TataThanapat/IREC2025_FlightCom/IREC2025_FlightComputer.kicad_pcb

## KiCad design IREC2025_FlightComputer.kicad_pcb (2025-05-31)

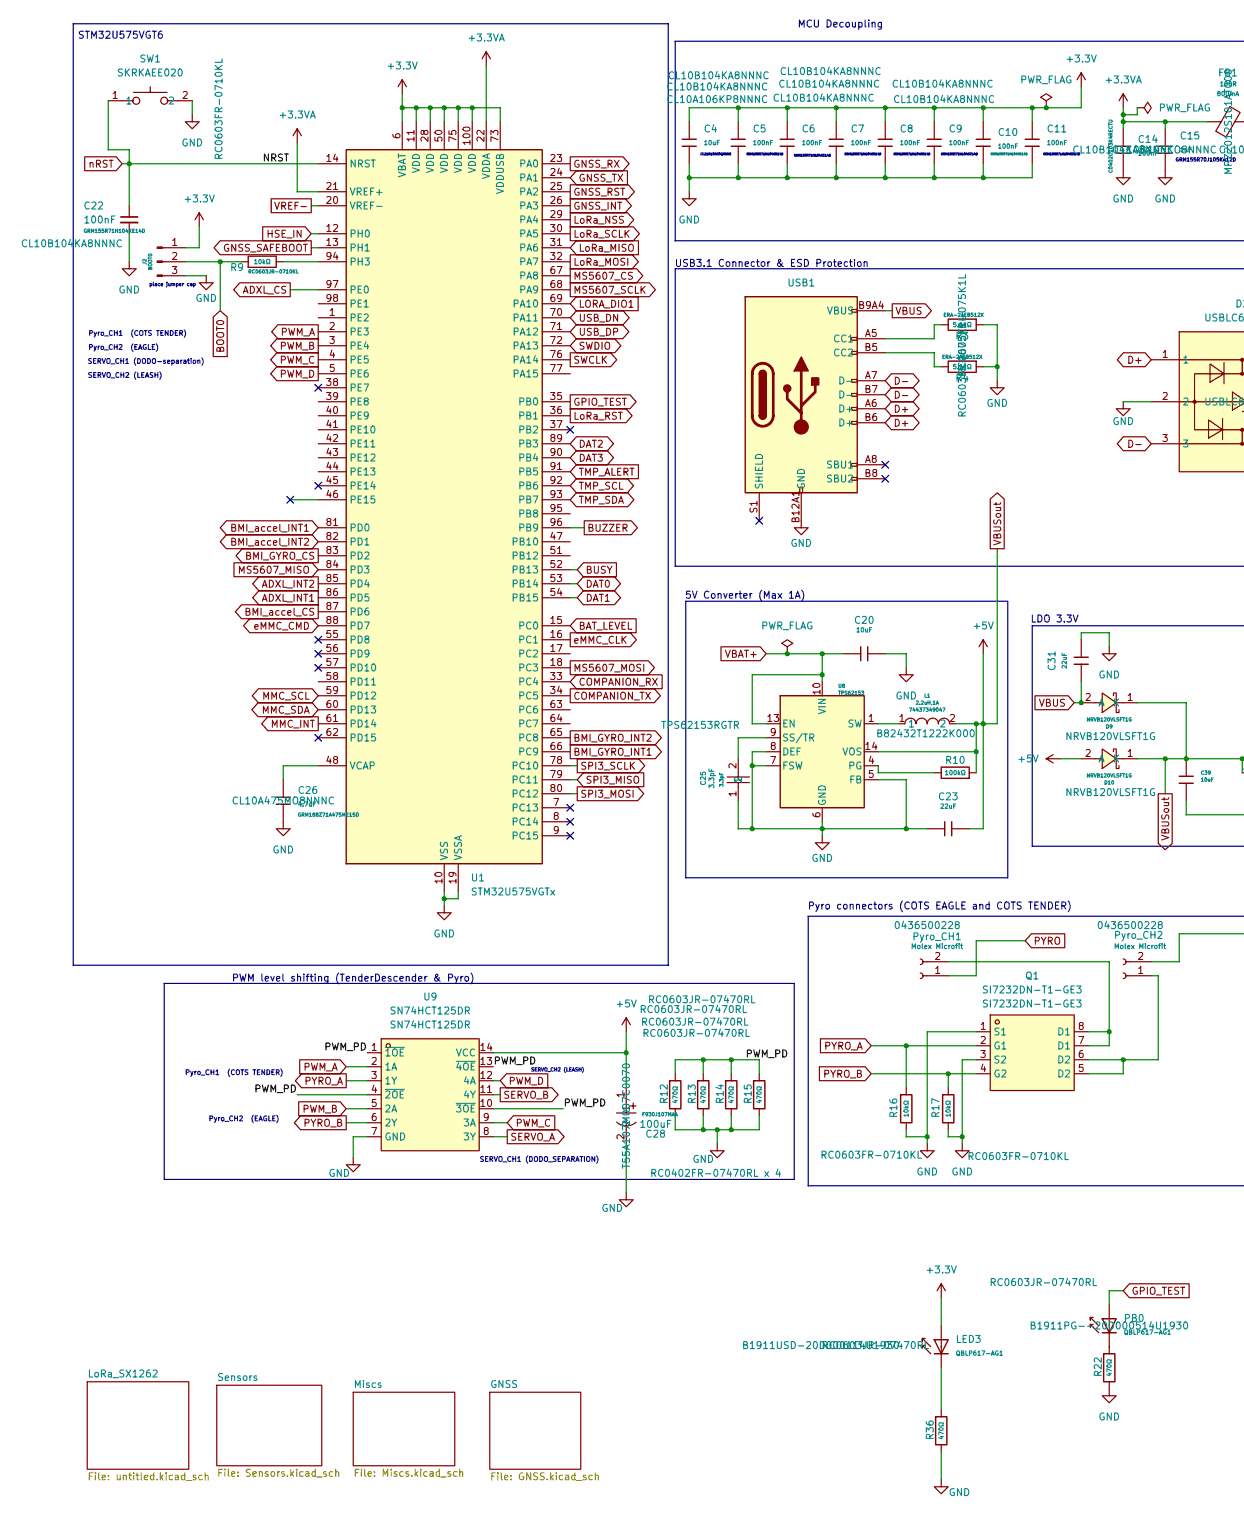
[picture p1: schematic IREC2025_FlightComputer.kicad_sch, part in row 1, column 1]

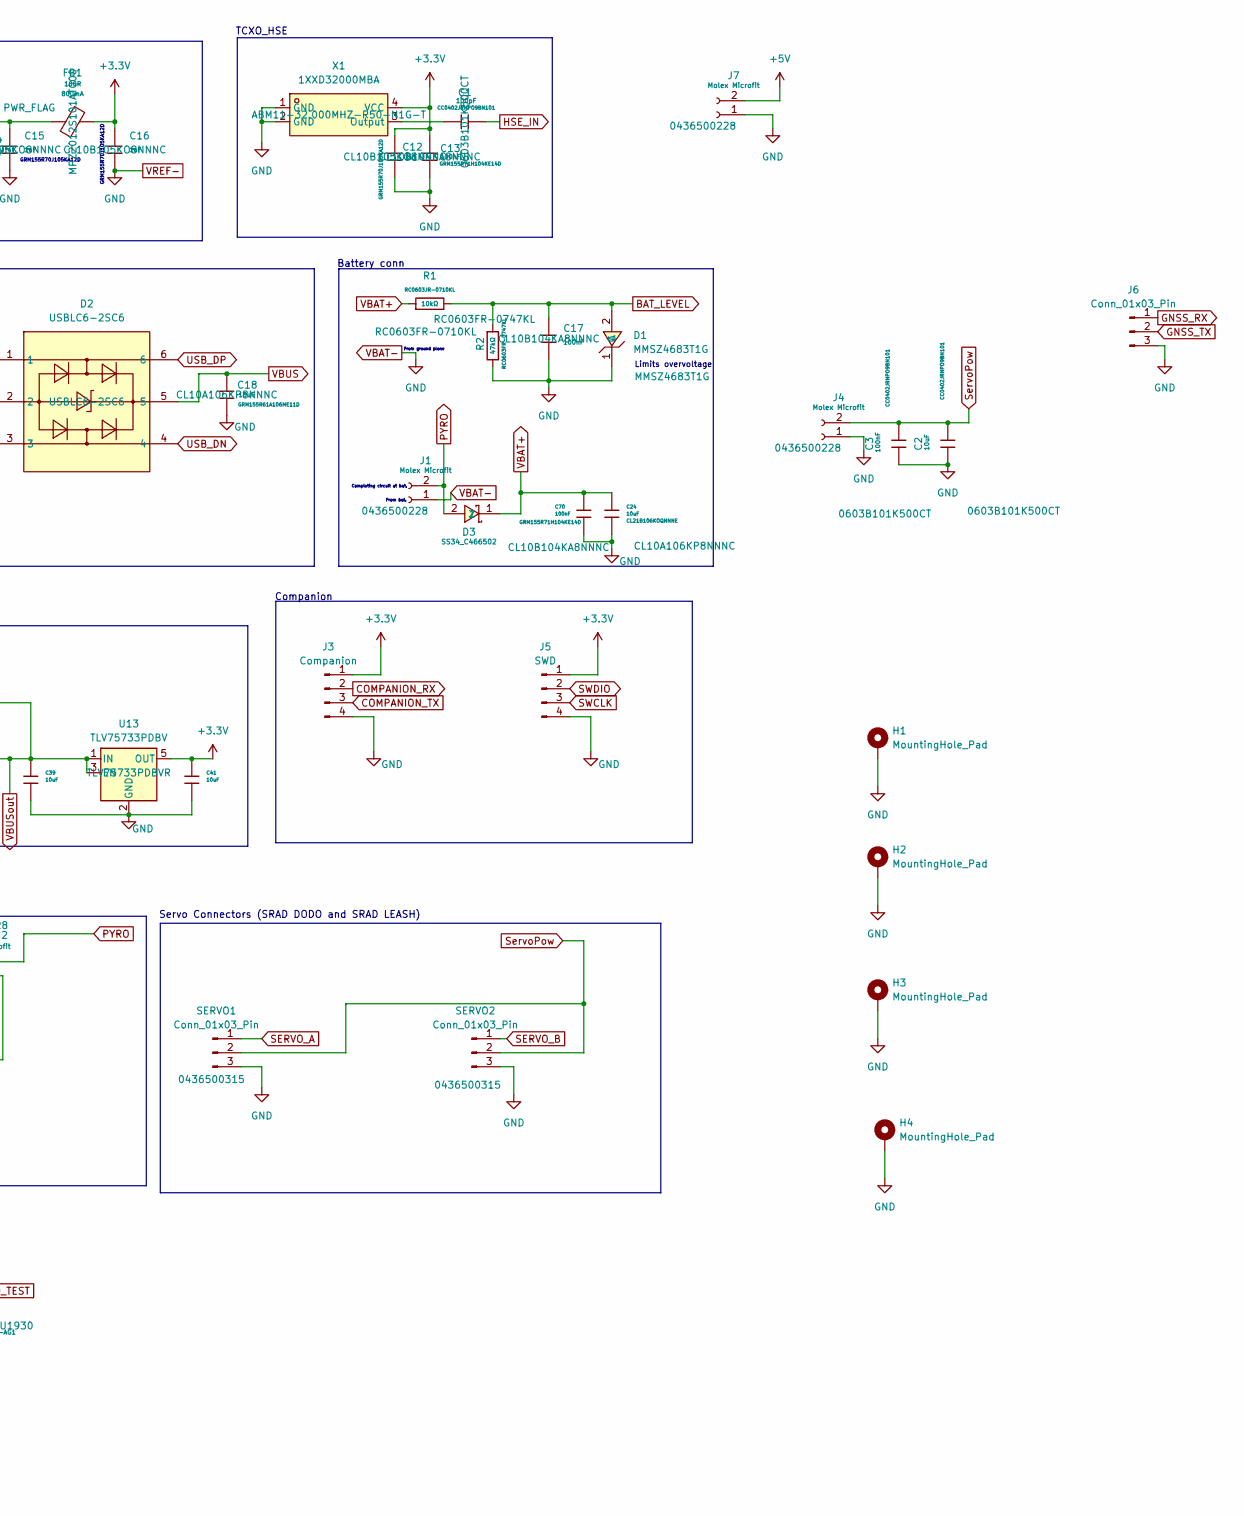
[picture p2: schematic IREC2025_FlightComputer.kicad_sch, part in row 1, column 2]

Parts:
C1: 100pF; C_0603; Voltage Rated 50V; Tolerance ±5%; Part 0402CG101J500NT; LCSC C1546
C2: 10uF; C_0603; Voltage Rated 50V; Tolerance ±5%; Part 0402CG101J500NT; LCSC C1546
C3: 100nF; C_0603; Voltage Rated 50V; Tolerance ±5%; Part 0402CG101J500NT; LCSC C1546
C4, C18: 10uF; C_0603; Voltage Rated 6.3V; Tolerance ±20%; Part CL05A106MQ5NUNC; LCSC C15525
C5, C6, C7, C8, C9, C10, C11, C13, C17: 100nF; C_0603; Voltage Rated 16V; Tolerance ±10%; Part CL05B104KO5NNNC; LCSC C1525
C12, C15, C16: 1uF; C_0603; Voltage Rated 25V; Tolerance ±10%; Part CL05A105KA5NQNC; LCSC C52923
C14: 100nF; C_0603; Voltage Rated 50V; Tolerance ±10%; Part CL05B103KB5NNNC; LCSC C15195
C20: 10uF; C_0603; Voltage Rated 25V; Tolerance ±20%; Part CL10A106MA8NRNC; LCSC C96446
C22: 100nF; C_0603; Digikey Parts CL10B104KA8NNNC
C23, C31: 22uF; C_0603; Voltage Rated 6.3V; Tolerance ±20%; Part CL10A226MQ8NRNC; LCSC C59461
C24, C39, C41: 10uF; C_0603; Voltage Rated 50V; Tolerance ±10%; Part CL31A106KBHNNNE; LCSC C13585
C25: 3.3pF; C_0603; LCSC Part C76906
C26: 4.7uF; C_0603; Voltage Rated 10V; Tolerance ±20%; Part CL05A475MP5NRNC; LCSC C23733
C28: 100uF; CAP-SMD_L3.2-W1.6; LCSC Part C561794
C70: 100nF; C_0603; Voltage Rated 50V; Tolerance ±10%; Part CL31B104KBCNNNC; LCSC C24497
D1: MMSZ4683T1G; SOD-123_L2.8-W1.8-LS3.7-RD; LCSC Part C235985
D2: USBLC6-2SC6; SOT-23-6_L2.9-W1.6-P0.95-LS2.8-BL; LCSC Part C7519
D3: SS34_C466502; DIOM7959X262N; LCSC Part C466502
D9, D10: NRVB120VLSFT1G; SOD-123_L2.7-W1.6-LS3.7-RD-1; LCSC Part C604264
FB1: 100R; FB_0603; Current Rating 800mA; Tolerance ±25%; Part GZ2012D101TF; LCSC C1015
H1, H2, H3, H4: MountingHole_Pad; MountingHole_3.2mm_M3_DIN965_Pad
J1, J4, J7: Molex Microfit; Molex_Micro-Fit_3.0_43650-0215_1x02_P3.00mm_Vertical; Digikey Parts 0436500228
J2: BOOT0; PinHeader_1x03_P2.54mm_Vertical
J3: Companion; PinHeader_1x04_P2.54mm_Vertical
J5: SWD; PinHeader_1x04_P2.54mm_Vertical
J6: Conn_01x03_Pin; PinHeader_1x03_P2.54mm_Vertical
L1: 2.2uH,1A; IND_EPCOS_B82432T_EPC; LCSC Part C5156236
LED3: QBLP617-AG1; D_0603; Part KT-0603R; LCSC C2286
PB0: QBLP617-AG1; D_0603; Part KT-0603R; LCSC C2286
Pyro_CH1, Pyro_CH2: Molex Microfit; Molex_Micro-Fit_3.0_43650-0215_1x02_P3.00mm_Vertical; Digikey Parts 0436500228
Q1: SI7232DN-T1-GE3; POWER-1212-8_L3.3-W3.3-P0.66-LS3.3-BL; LCSC Part C144854
R1, R9: 10kΩ; R_0603; Overload Voltage (Max) 50V; Tolerance ±1%; Part 0402WGF1002TCE; LCSC C25744
R2: 47kΩ; R_0603; Overload Voltage (Max) 50V; Tolerance ±1%; Part 0402WGF4702TCE; LCSC C25792
R3, R4: 5.1kΩ; R_0603; Overload Voltage (Max) 50V; Tolerance ±1%; Part 0402WGF5101TCE; LCSC C25905
R10: 100kΩ; R_0603; Overload Voltage (Max) 50V; Tolerance ±1%; Part 0402WGF1003TCE; LCSC C25741
R12, R13, R14, R15, R22, R36: 470Ω; R_0603; Overload Voltage (Max) 50V; Tolerance ±1%; Part 0402WGF4700TCE; LCSC C25117
R16, R17: 10kΩ; R_0603; Overload Voltage (Max) 50V; Tolerance ±1%; Part 0402WGF3301TCE; LCSC C25890
SERVO1, SERVO2: Conn_01x03_Pin; Molex_Micro-Fit_3.0_43650-0315_1x03_P3.00mm_Vertical; Digikey Parts 0436500315
SW1: SKRKAEE020; SW-SMD_L3.9-W3.0-P4.45; LCSC Part C115357
U1: STM32U575VGTx; LQFP-100_14x14mm_P0.5mm
U8: TPS62153; VQFN-16-1EP_3x3mm_P0.5mm_EP1.68x1.68mm_ThermalVias; Digikey Parts TPS62153RGTR
U9: SN74HCT125DR; SOIC-14_L8.7-W3.9-P1.27-LS6.0-BL; LCSC Part C352957
U13: TLV75733PDBV; SOT-23-5; Digikey Parts TLV75733PDBVR
USB1: Connector, USB-TYPE-C-16P; TYPE-C-SMD_HX-TYPE-C-16PIN; LCSC C2927039
X1: 1XXD32000MBA; OSC-SMD_4P-L2.0-W1.6-BL_1XXD; LCSC Part C253694

Connections:
+3.3V: C4.1, C5.1, C6.1, C7.1, C8.1, C9.1, C10.1, C11.1, C12.1, C13.1, C16.1, C41.1, FB1.2, J2.1, J3.1, J5.1, LED3.2, U1.6 (VBAT), U1.11 (VDD), U1.28 (VDD), U1.50 (VDD), U1.73 (VDDUSB), U1.75 (VDD), U1.100 (VDD), U13.5 (OUT), X1.4 (VCC); also elsewhere on the board
+3.3VA: C14.1, C15.1, FB1.1, U1.21 (VREF+), U1.22 (VDDA)
/PWM_PD: R12.1, R13.1, R14.1, R15.1, U9.1 (~1OE), U9.4 (~2OE), U9.10 (~3OE), U9.13 (~4OE)
ADXL_CS: U1.97 (PE0); also elsewhere on the board
ADXL_INT1: U1.86 (PD5); also elsewhere on the board
ADXL_INT2: U1.85 (PD4); also elsewhere on the board
BAT_LEVEL: C17.1, D1.2 (A), R1.2, R2.1, U1.15 (PC0)
BMI_GYRO_CS: U1.83 (PD2); also elsewhere on the board
BMI_GYRO_INT1: U1.66 (PC9); also elsewhere on the board
BMI_GYRO_INT2: U1.65 (PC8); also elsewhere on the board
BMI_accel_CS: U1.87 (PD6); also elsewhere on the board
BMI_accel_INT1: U1.81 (PD0); also elsewhere on the board
BMI_accel_INT2: U1.82 (PD1); also elsewhere on the board
BOOT0: J2.2, R9.1
BUSY: U1.52 (PB13); also elsewhere on the board
BUZZER: U1.96 (PB9); also elsewhere on the board
COMPANION_RX: J3.2, U1.33 (PC4)
COMPANION_TX: J3.3, U1.34 (PC5)
D+: D2.1, USB1.A6 (D+), USB1.B6 (D+)
D-: D2.3, USB1.A7 (D-), USB1.B7 (D-)
DAT0: U1.53 (PB14); also elsewhere on the board
DAT1: U1.54 (PB15); also elsewhere on the board
DAT2: U1.89 (PB3); also elsewhere on the board
DAT3: U1.90 (PB4); also elsewhere on the board
GNSS_INT: U1.26 (PA3); also elsewhere on the board
GNSS_RST: U1.25 (PA2); also elsewhere on the board
GNSS_RX: J6.1, U1.23 (PA0); also elsewhere on the board
GNSS_SAFEBOOT: U1.13 (PH1); also elsewhere on the board
GNSS_TX: J6.2, U1.24 (PA1); also elsewhere on the board
GPIO_TEST: PB0.2, U1.35 (PB0)
HSE_IN: C1.2, U1.12 (PH0)
LORA_DIO1: U1.69 (PA10); also elsewhere on the board
LoRa_MISO: U1.31 (PA6); also elsewhere on the board
LoRa_MOSI: U1.32 (PA7); also elsewhere on the board
LoRa_NSS: U1.29 (PA4); also elsewhere on the board
LoRa_RST: U1.36 (PB1); also elsewhere on the board
LoRa_SCLK: U1.30 (PA5); also elsewhere on the board
MMC_INT: U1.61 (PD14); also elsewhere on the board
MMC_SCL: U1.59 (PD12); also elsewhere on the board
MMC_SDA: U1.60 (PD13); also elsewhere on the board
MS5607_CS: U1.67 (PA8); also elsewhere on the board
MS5607_MISO: U1.84 (PD3); also elsewhere on the board
MS5607_MOSI: U1.18 (PC3); also elsewhere on the board
MS5607_SCLK: U1.68 (PA9); also elsewhere on the board
unnamed: L1.1, U8.1 (SW), U8.2 (SW), U8.3 (SW)
unnamed: LED3.1, R36.1
unnamed: PB0.1, R22.1
unnamed: Pyro_CH1.2, Q1.7 (D1), Q1.8 (D1)
unnamed: Pyro_CH2.1, Q1.5 (D2), Q1.6 (D2)
unnamed: R9.2, U1.94 (PH3)
unnamed: C26.1, U1.48 (VCAP)
unnamed: R10.2, U8.4 (PG)
unnamed: C25.2, U8.9 (SS/TR)
unnamed: R3.2, USB1.A5 (CC1)
unnamed: R4.2, USB1.B5 (CC2)
unnamed: C1.1, X1.3 (Output)
PWM_A: U1.2 (PE3), U9.2 (1A)
PWM_B: U1.3 (PE4), U9.5 (2A)
PWM_C: U1.4 (PE5), U9.9 (3A)
PWM_D: U1.5 (PE6), U9.12 (4A)
PYRO: D3.2, J1.2, Pyro_CH1.1, Pyro_CH2.2
PYRO_A: Q1.2 (G1), R16.1, U9.3 (1Y)
PYRO_B: Q1.4 (G2), R17.1, U9.6 (2Y)
SERVO_A: SERVO1.1, U9.8 (3Y)
SERVO_B: SERVO2.1, U9.11 (4Y)
SWCLK: J5.3, U1.76 (PA14)
SWDIO: J5.2, U1.72 (PA13)
ServoPow: C2.2, C3.2, J4.2, SERVO1.2, SERVO2.2
TMP_ALERT: U1.91 (PB5); also elsewhere on the board
TMP_SCL: U1.92 (PB6); also elsewhere on the board
TMP_SDA: U1.93 (PB7); also elsewhere on the board
USB_DN: D2.4, U1.70 (PA11)
USB_DP: D2.6, U1.71 (PA12)
VBAT+: C20.1, C24.1, C70.1, D3.1, R1.1, U8.10 (VIN), U8.11 (VIN), U8.12 (VIN), U8.13 (EN)
VBAT-: C2.1, C3.1, C4.2, C5.2, C6.2, C7.2, C8.2, C9.2, C10.2, C11.2, C12.2, C13.2, C14.2, C15.2, C16.2, C17.2, C18.2, C20.2, C22.2, C23.1, C24.2, C25.1, C26.2, C28.2, C31.2, C39.2, C41.2, C70.2, D1.1 (C), D2.2, H1.1, H2.1, H3.1, H4.1, J1.1, J2.3, J3.4, J4.1, J5.4, J6.3, J7.1, Q1.1 (S1), Q1.3 (S2), R2.2, R3.1, R4.1, R12.2, R13.2, R14.2, R15.2, R16.2, R17.2, R22.2, R36.2, SERVO1.3, SERVO2.3, SW1.2, U1.10 (VSS), U1.19 (VSSA), U1.20 (VREF-), U1.27 (VSS), U1.49 (VSS), U1.74 (VSS), U1.99 (VSS), U8.5 (FB), U8.6 (GND), U8.7 (FSW), U8.8 (DEF), U8.15 (GND), U8.16 (GND), U8.17 (GND), U9.7 (GND), U13.2 (GND), USB1.A12B1 (GND), USB1.B12A1 (GND), X1.1 (GND), X1.2 (GND); also elsewhere on the board
VBUS: C18.1, C31.1, D2.5, D9.2 (A), USB1.A9B4 (VBUS), USB1.B9A4 (VBUS)
VBUSout: C23.2, C28.1, C39.1, D9.1 (K), D10.1 (K), D10.2 (A), J7.2, L1.2, R10.1, U8.14 (VOS), U9.14 (VCC), U13.1 (IN), U13.3 (EN); also elsewhere on the board
eMMC_CLK: U1.16 (PC1); also elsewhere on the board
eMMC_CMD: U1.88 (PD7); also elsewhere on the board
nRST: C22.1, SW1.1, U1.14 (NRST)

Notes on the sheet:
Pyro connectors (COTS EAGLE and COTS TENDER)
PWM level shifting (TenderDescender & Pyro)
SERVO_CH2 (LEASH)
Pyro_CH2 (EAGLE)
STM32U575VGT6
GRM155R71H104KE14D
Battery conn
Completing circuit at bat.
Pyro_CH1 (COTS TENDER)
CL21B106KOQNNNE
Limits overvoltage
SERVO_CH1 (DODO_SEPARATION)
5V Converter (Max 1A)
GRM155R70J105KA12D
Servo Connectors (SRAD DODO and SRAD LEASH)
From ground plane
place jumper cap
MCU Decoupling
SERVO_CH1 (DODO-separation)
LDO 3.3V
From bat.
TCXO_HSE
USB3.1 Connector & ESD Protection
Companion

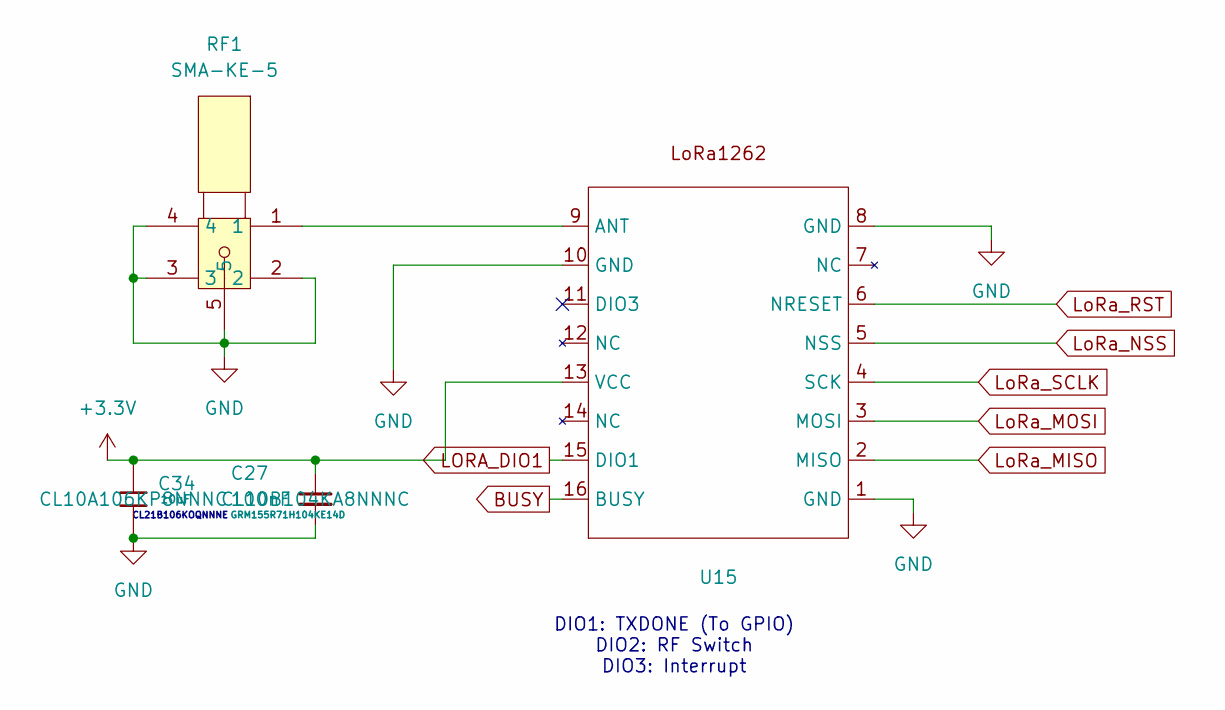
[picture p3: schematic untitled.kicad_sch]

Parts:
C27: 100nF; C_0603; Digikey Parts CL10B104KA8NNNC
C34: 10uF; C_0603; Voltage Rated 6.3V; Tolerance ±20%; Part CL05A106MQ5NUNC; LCSC C15525
RF1: SMA-KE-5; SMA-TH_SMA-KHDB_C9900020423; LCSC Part C20415804
U15: G-NiceRF LoRa1262-915

Connections:
+3.3V: C27.1, C34.1, U15.13 (VCC); also elsewhere on the board
BUSY: U15.16 (BUSY); also elsewhere on the board
LORA_DIO1: U15.15 (DIO1); also elsewhere on the board
LoRa_MISO: U15.2 (MISO); also elsewhere on the board
LoRa_MOSI: U15.3 (MOSI); also elsewhere on the board
LoRa_NSS: U15.5 (NSS); also elsewhere on the board
LoRa_RST: U15.6 (NRESET); also elsewhere on the board
LoRa_SCLK: U15.4 (SCK); also elsewhere on the board
unnamed: RF1.1, U15.9 (ANT)
VBAT-: C27.2, C34.2, RF1.2, RF1.3, RF1.4, RF1.5, U15.1 (GND), U15.8 (GND), U15.10 (GND); also elsewhere on the board

Notes on the sheet:
DIO1: TXDONE (To GPIO) DIO2: RF Switch DIO3: Interrupt
CL21B106KOQNNNE

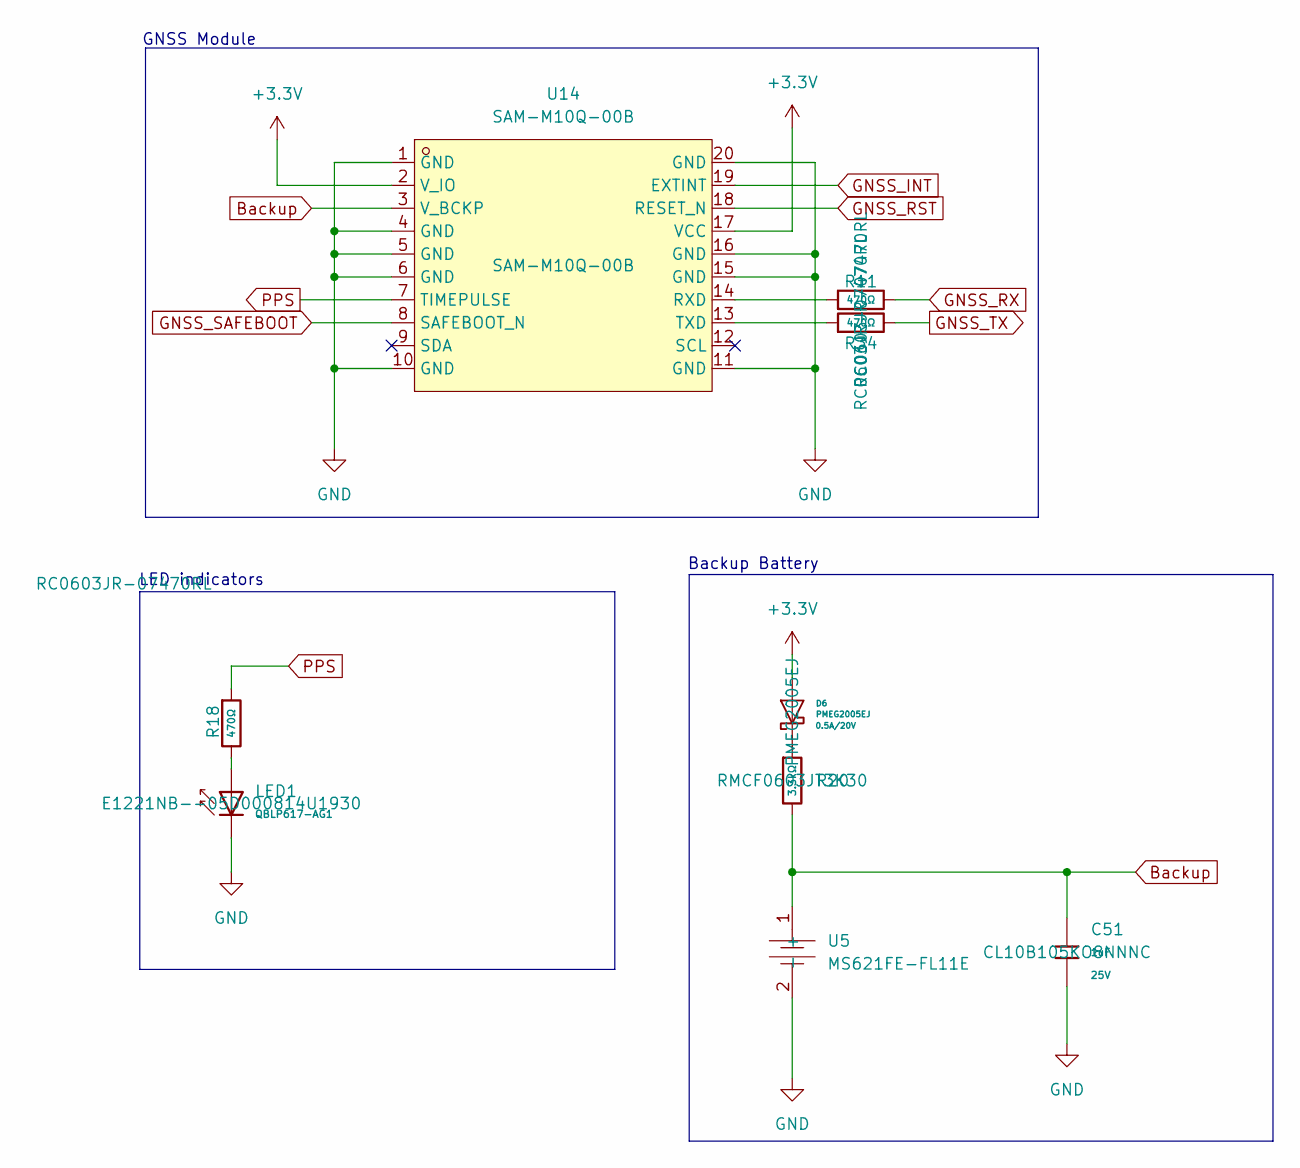
[picture p4: schematic GNSS.kicad_sch]

Parts:
C51: 1uF; C_0603; Voltage Rated 25V; Tolerance ±10%; Part CL05A105KA5NQNC; LCSC C52923
D6: PMEG2005EJ; D_SOD-323F; Ratings 0.5A/20V; Digikey Parts PMEG2005EJ
LED1: QBLP617-AG1; D_0603; Part KT-0603R; LCSC C2286
R11, R18, R34: 470Ω; R_0603; Overload Voltage (Max) 50V; Tolerance ±1%; Part 0402WGF4700TCE; LCSC C25117
R20: 3.3kΩ; R_0603; Overload Voltage (Max) 50V; Tolerance ±1%; Part 0402WGF3301TCE; LCSC C25890
U5: MS621FE-FL11E; BAT-SMD_FL11E; LCSC Part C80909
U14: SAM-M10Q-00B; LCC-20_L15.5-W15.5-P1.90_SAM-M10Q-00B; LCSC Part C5443880

Connections:
+3.3V: D6.2 (A), U14.2 (V_IO), U14.17 (VCC); also elsewhere on the board
Backup: C51.1, R20.2, U5.1 (+), U14.3 (V_BCKP)
GNSS_INT: U14.19 (EXTINT); also elsewhere on the board
GNSS_RST: U14.18 (RESET_N); also elsewhere on the board
GNSS_RX: R11.2; also elsewhere on the board
GNSS_SAFEBOOT: U14.8 (SAFEBOOT_N); also elsewhere on the board
GNSS_TX: R34.2; also elsewhere on the board
unnamed: D6.1 (K), R20.1
unnamed: LED1.2, R18.2
unnamed: R11.1, U14.14 (RXD)
unnamed: R34.1, U14.13 (TXD)
PPS: R18.1, U14.7 (TIMEPULSE)
VBAT-: C51.2, LED1.1, U5.2 (-), U14.1 (GND), U14.4 (GND), U14.5 (GND), U14.6 (GND), U14.10 (GND), U14.11 (GND), U14.15 (GND), U14.16 (GND), U14.20 (GND); also elsewhere on the board

Notes on the sheet:
GNSS Module
LED indicators
Backup Battery

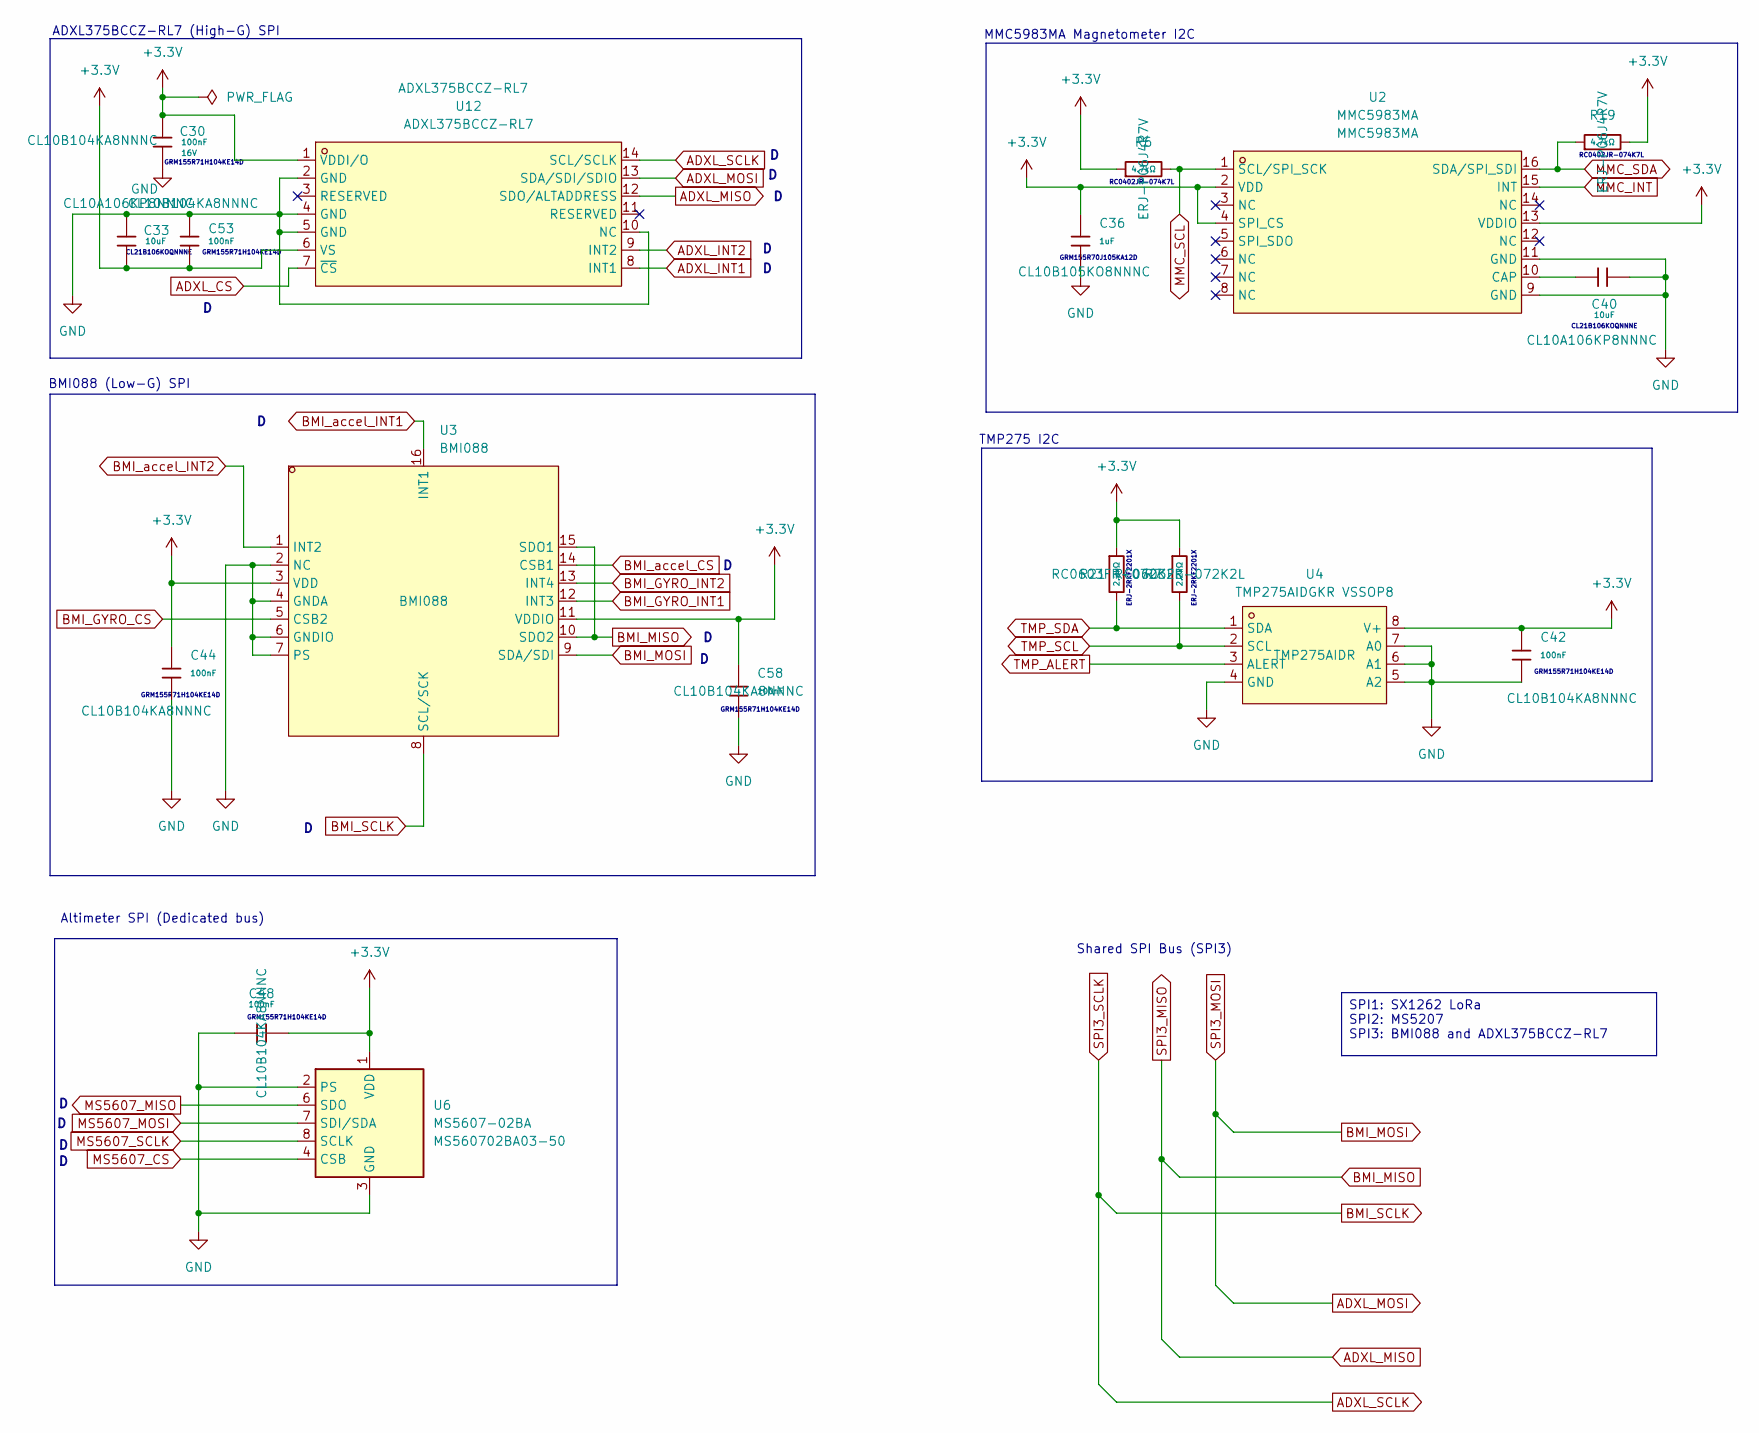
[picture p5: schematic Sensors.kicad_sch]

Parts:
C30, C42, C44, C48, C53, C58: 100nF; C_0603; Voltage Rated 16V; Tolerance ±10%; Part CL05B104KO5NNNC; LCSC C1525
C33, C40: 10uF; C_0603; Voltage Rated 6.3V; Tolerance ±20%; Part CL05A106MQ5NUNC; LCSC C15525
C36: 1uF; C_0603; Voltage Rated 25V; Tolerance ±10%; Part CL05A105KA5NQNC; LCSC C52923
R6, R19: 4.7kΩ; R_0603; Overload Voltage (Max) 50V; Tolerance ±1%; Part 0402WGF4701TCE; LCSC C25900
R7, R21: 2.2kΩ; R_0603; Overload Voltage (Max) 50V; Tolerance ±1%; Part 0402WGF2201TCE; LCSC C25879
U2: MMC5983MA; LGA-16_L3.0-W3.0-P0.50-BL_SQ; LCSC Part C404329
U3: BMI088; LGA-16_L4.5-W3.0-P0.50-BL; LCSC Part C194919
U4: TMP275AIDGKR VSSOP8; VSSOP-8_L3.0-W3.0-P0.65-LS5.0-BL; LCSC Part C87815
U6: MS5607-02BA; LGA-8_3x5mm_P1.25mm; Digikey Parts MS560702BA03-50
U12: ADXL375BCCZ-RL7; LGA-14_L5.0-W3.0-P0.80-BL; LCSC Part C481898

Connections:
+3.3V: C30.1, C33.2, C36.1, C42.1, C44.1, C48.2, C53.2, C58.1, R6.1, R7.1, R19.2, R21.1, U2.2 (VDD), U2.4 (SPI_CS), U2.13 (VDDIO), U3.3 (VDD), U3.11 (VDDIO), U4.8 (V+), U6.1 (VDD), U12.1 (VDDI/O), U12.6 (VS); also elsewhere on the board
ADXL_CS: U12.7 (~CS); also elsewhere on the board
ADXL_INT1: U12.8 (INT1); also elsewhere on the board
ADXL_INT2: U12.9 (INT2); also elsewhere on the board
BMI_GYRO_CS: U3.5 (CSB2); also elsewhere on the board
BMI_GYRO_INT1: U3.12 (INT3); also elsewhere on the board
BMI_GYRO_INT2: U3.13 (INT4); also elsewhere on the board
BMI_accel_CS: U3.14 (CSB1); also elsewhere on the board
BMI_accel_INT1: U3.16 (INT1); also elsewhere on the board
BMI_accel_INT2: U3.1 (INT2); also elsewhere on the board
MMC_INT: U2.15 (INT); also elsewhere on the board
MMC_SCL: R6.2, U2.1 (SCL/SPI_SCK); also elsewhere on the board
MMC_SDA: R19.1, U2.16 (SDA/SPI_SDI); also elsewhere on the board
MS5607_CS: U6.4 (CSB), U6.5 (CSB); also elsewhere on the board
MS5607_MISO: U6.6 (SDO); also elsewhere on the board
MS5607_MOSI: U6.7 (SDI/SDA); also elsewhere on the board
MS5607_SCLK: U6.8 (SCLK); also elsewhere on the board
unnamed: C40.1, U2.10 (CAP)
TMP_ALERT: U4.3 (ALERT); also elsewhere on the board
TMP_SCL: R7.2, U4.2 (SCL); also elsewhere on the board
TMP_SDA: R21.2, U4.1 (SDA); also elsewhere on the board
VBAT-: C30.2, C33.1, C36.2, C40.2, C42.2, C44.2, C48.1, C53.1, C58.2, U2.9 (GND), U2.11 (GND), U3.2 (NC), U3.4 (GNDA), U3.6 (GNDIO), U3.7 (PS), U4.4 (GND), U4.5 (A2), U4.6 (A1), U4.7 (A0), U6.2 (PS), U6.3 (GND), U12.2 (GND), U12.4 (GND), U12.5 (GND), U12.10 (NC); also elsewhere on the board

Notes on the sheet:
Shared SPI Bus (SPI3)
ERJ-2RKF2201X
CL21B106KOQNNNE
GRM155R71H104KE14D
RC0402JR-074K7L
GRM155R70J105KA12D
TMP275 I2C
BMI088 (Low-G) SPI
MMC5983MA Magnetometer I2C
ADXL375BCCZ-RL7 (High-G) SPI
Altimeter SPI (Dedicated bus)
SPI1: SX1262 LoRa SPI2: MS5207 SPI3: BMI088 and ADXL375BCCZ-RL7

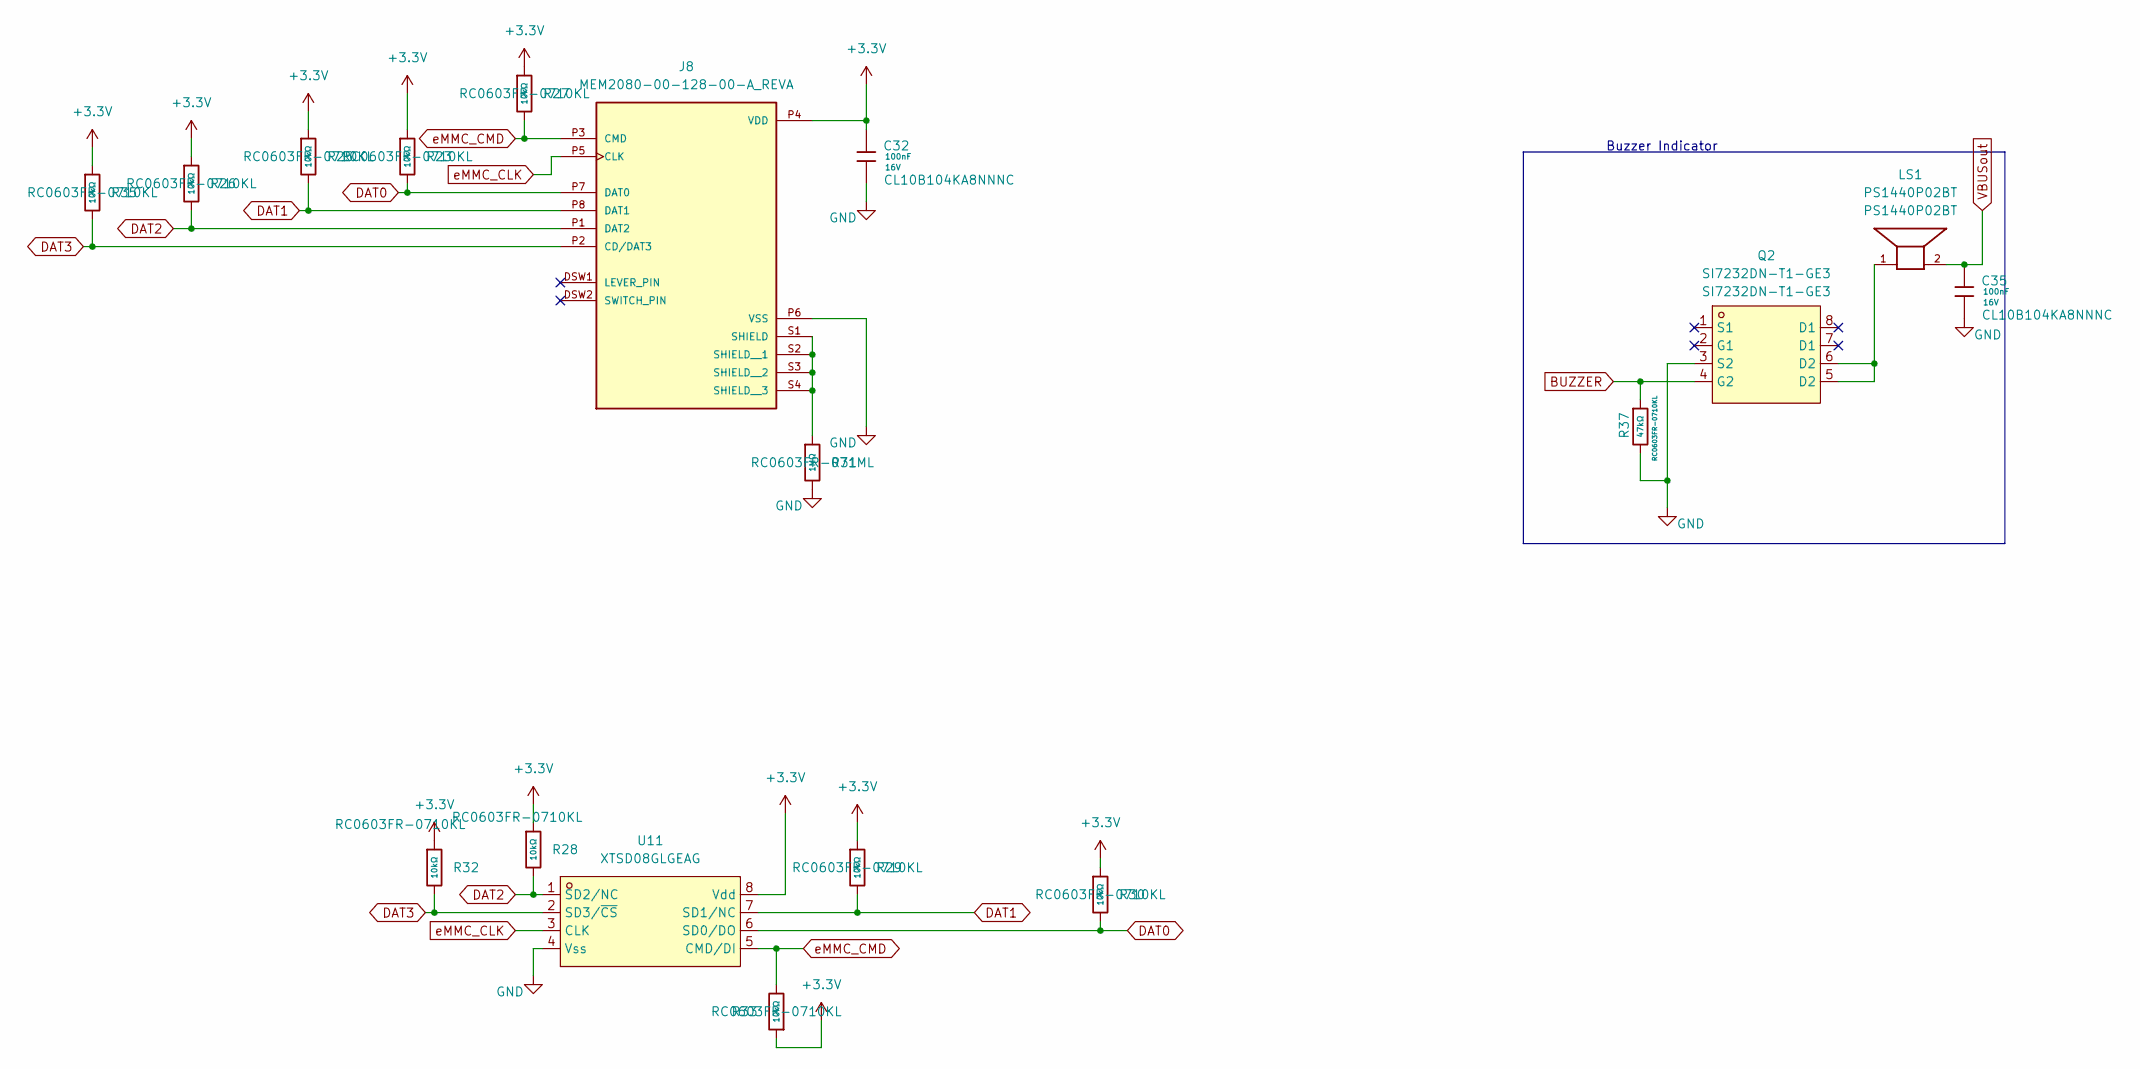
[picture p6: schematic Miscs.kicad_sch]

Parts:
C32, C35: 100nF; C_0603; Voltage Rated 16V; Tolerance ±10%; Part CL05B104KO5NNNC; LCSC C1525
J8: MEM2080-00-128-00-A_REVA; GCT_MEM2080-00-128-00-A_REVA; PARTREV A; Digikey Parts MEM2080-00-128-00-A
LS1: PS1440P02BT; PS1440P02BT_BUZZER_PS1440P02BT; Digikey Parts PS1440P02BT
Q2: SI7232DN-T1-GE3; POWER-1212-8_L3.3-W3.3-P0.66-LS3.3-BL; LCSC Part C144854
R23, R25, R26, R27, R28, R29, R30, R32, R33, R35: 10kΩ; R_0603; Overload Voltage (Max) 75V; Tolerance ±1%; Part 0603WAF1002T5E; LCSC C25804
R31: 1MΩ; R_0603; Overload Voltage (Max) 75V; Tolerance ±1%; Part 0603WAF1004T5E; LCSC C22935
R37: 47kΩ; R_0603; Overload Voltage (Max) 50V; Tolerance ±1%; Part 0402WGF3301TCE; LCSC C25890
U11: XTSD08GLGEAG; LGA-8_L6.0-W8.0-P1.27-BL; LCSC Part C558840

Connections:
+3.3V: C32.1, J8.P4 (VDD), R23.1, R25.1, R26.1, R27.1, R28.1, R29.1, R30.1, R32.1, R33.1, R35.1, U11.8 (Vdd); also elsewhere on the board
BUZZER: Q2.4 (G2), R37.1; also elsewhere on the board
DAT0: J8.P7 (DAT0), R23.2, R30.2, U11.6 (SD0/DO); also elsewhere on the board
DAT1: J8.P8 (DAT1), R25.2, R29.2, U11.7 (SD1/NC); also elsewhere on the board
DAT2: J8.P1 (DAT2), R26.2, R28.2, U11.1 (SD2/NC); also elsewhere on the board
DAT3: J8.P2 (CD/DAT3), R32.2, R35.2, U11.2 (SD3/~CS); also elsewhere on the board
unnamed: J8.S1 (SHIELD), J8.S2 (SHIELD__1), J8.S3 (SHIELD__2), J8.S4 (SHIELD__3), R31.1
unnamed: LS1.1, Q2.5 (D2), Q2.6 (D2)
VBAT-: C32.2, C35.2, J8.P6 (VSS), Q2.3 (S2), R31.2, R37.2, U11.4 (Vss); also elsewhere on the board
VBUSout: C35.1, LS1.2; also elsewhere on the board
eMMC_CLK: J8.P5 (CLK), U11.3 (CLK); also elsewhere on the board
eMMC_CMD: J8.P3 (CMD), R27.2, R33.2, U11.5 (CMD/DI); also elsewhere on the board

Notes on the sheet:
Buzzer Indicator

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
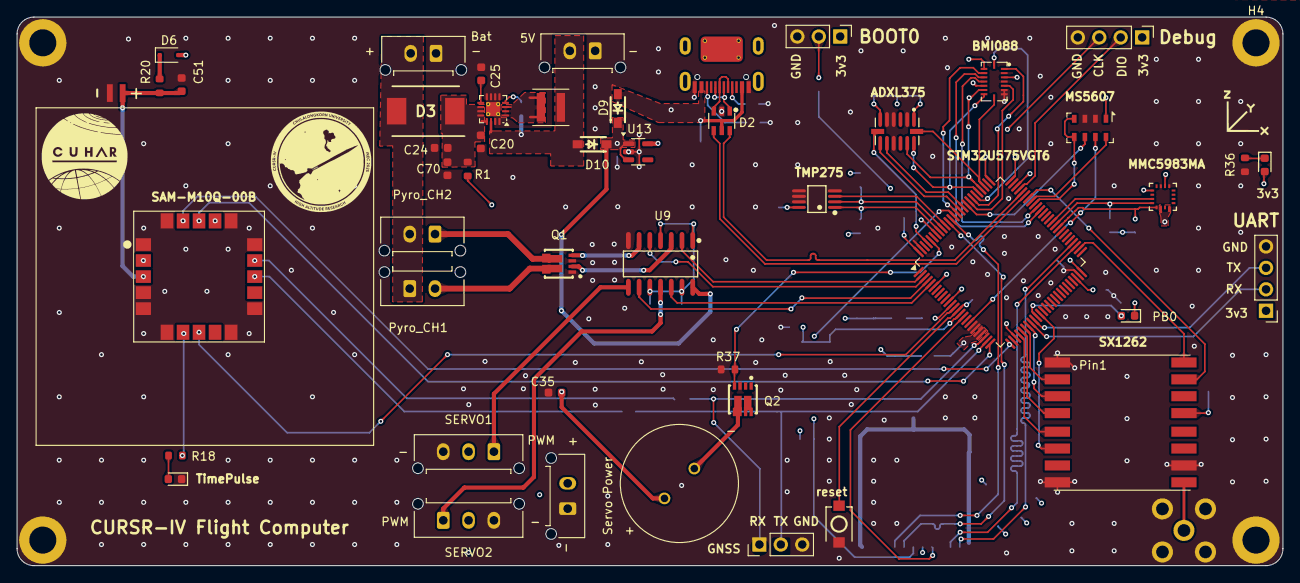
[picture p7: board IREC2025_FlightComputer.kicad_pcb from above]

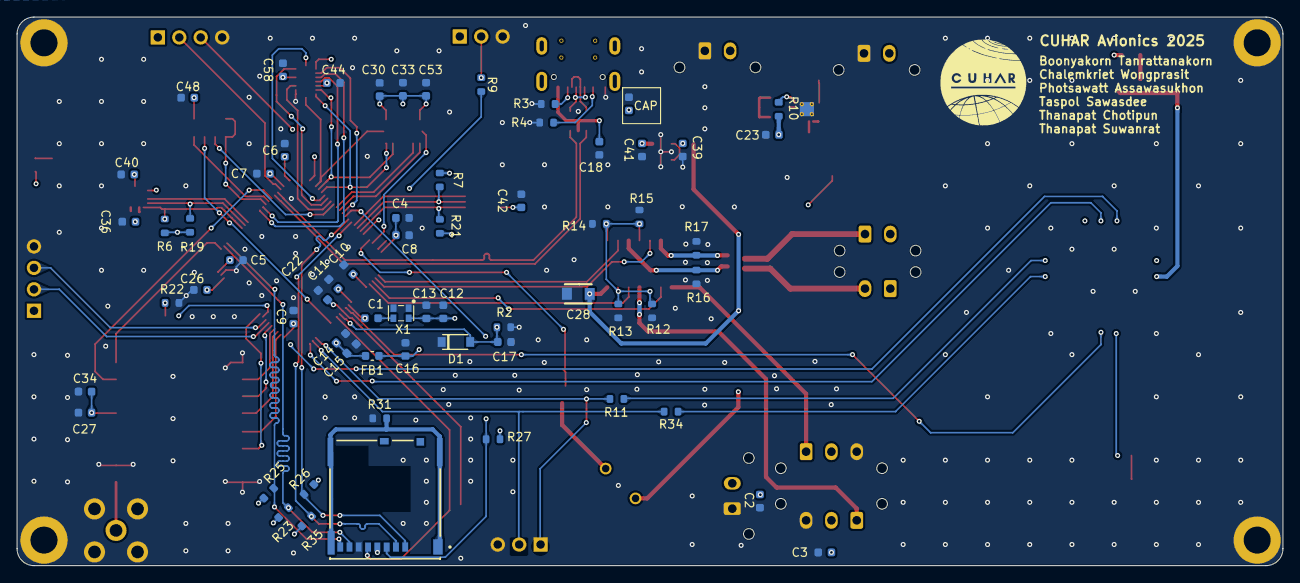
[picture p8: board IREC2025_FlightComputer.kicad_pcb from below]

Board: 4 copper layers, 150.0 x 65.0 mm, 119 parts (65 on the bottom side), 93 nets.

Other parts of the board:
LOGO: LOGO; CUHARLOGOMOD
LOGO#2: LOGO; CUHARLOGOMOD
