TataThanapat/IREC2025_FlightCom/ServoConverter/ServoConverter.kicad_pcb

## KiCad design ServoConverter/ServoConverter.kicad_pcb (2025-05-16)

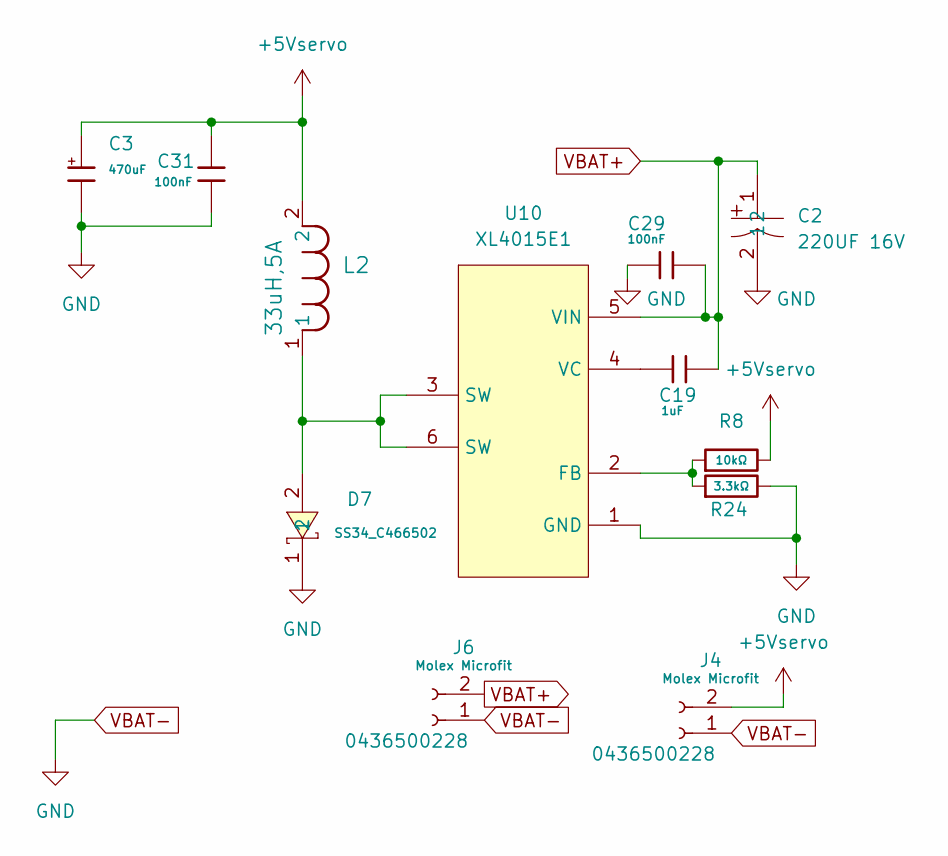
[picture p9: schematic ServoConverter.kicad_sch]

Parts:
C2: 220UF 16V; CAP-SMD_BD6.3-L6.6-W6.6-LS7.4-FD; LCSC Part C9900003178
C3: 470uF; CP_Elec_8x10; Voltage Rated 50V; Part EGT477M1HG16RRS0P; LCSC C3015599
C19: 1uF; C_0603; Voltage Rated 25V; Tolerance ±10%; Part CL05A105KA5NQNC; LCSC C52923
C29, C31: 100nF; C_0603; Voltage Rated 16V; Tolerance ±10%; Part CL05B104KO5NNNC; LCSC C1525
D7: SS34_C466502; DIOM7959X262N; LCSC Part C466502
J4, J6: Molex Microfit; Molex_Micro-Fit_3.0_43650-0215_1x02_P3.00mm_Vertical; Digikey Parts 0436500228
L2: 33uH,5A; L_Bourns_SRR1208_12.7x12.7mm; Digikey HCM1A1307V2-330-R
R8: 10kΩ; R_0603; Overload Voltage (Max) 75V; Tolerance ±1%; Part 0603WAF1002T5E; LCSC C25804
R24: 3.3kΩ; R_0603; Overload Voltage (Max) 75V; Tolerance ±1%; Part 0603WAF3301T5E; LCSC C22978
U10: XL4015E1; TO-263-5_L10.2-W8.9-P1.70-TL; LCSC Part C51661

Connections:
+5Vservo: C3.1, C31.2, J4.2, L2.2, R8.2
unnamed: D7.2, L2.1, U10.3 (SW), U10.6 (SW)
unnamed: R8.1, R24.1, U10.2 (FB)
unnamed: C19.1, U10.4 (VC)
VBAT+: C2.1, C19.2, C29.2, J6.2, U10.5 (VIN)
VBAT-: C2.2, C3.2, C29.1, C31.1, D7.1, J4.1, J6.1, R24.2, U10.1 (GND)

Board: 2 copper layers, 12 parts (0 on the bottom side), 6 nets, no tracks yet.
