TataThanapat/IREC2025_FlightCom/Flight com.ioc

Mcu.UserName=STM32U575VGTx
PA0.GPIO_Label=GNSS_TX
PA0.Signal=UART4_TX
PA1.GPIO_Label=GNSS_RX
PA1.Signal=UART4_RX
PA10.GPIO_Label=LoRa_INT
PA10.Signal=GPXTI10
PA11.Signal=USB_OTG_FS_DM
PA12.Signal=USB_OTG_FS_DP
PA2.GPIO_Label=GNSS_RST
PA2.Signal=GPIO_Output
PA4.Signal=SPI1_NSS
PA5.Signal=SPI1_SCK
PA6.Signal=SPI1_MISO
PA7.Signal=SPI1_MOSI
PB10.Signal=SPI2_SCK
PB12.Signal=SPI2_NSS
PB13.GPIO_Label=LORA_BUSY
PB13.Signal=GPIO_Input
PB14.Signal=SDMMC2_D0
PB15.Signal=SDMMC2_D1
PB5.GPIO_Label=TMP_ALERT
PB5.Signal=GPIO_Input
PB6.Signal=I2C1_SCL
PB7.Signal=I2C1_SDA
PB8.Signal=SDMMC2_D4
PB9.Signal=SDMMC2_D5
PC1.Signal=SDMMC2_CK
PC10.Signal=SPI3_SCK
PC11.Signal=SPI3_MISO
PC12.Signal=SPI3_MOSI
PC2.Signal=SPI2_MISO
PC3.Signal=SPI2_MOSI
PC4.GPIO_Label=COMPANION_TX
PC4.Signal=USART3_TX
PC5.GPIO_Label=COMPANION_RX
PC5.Signal=USART3_RX
PC6.Signal=SDMMC2_D6
PC7.Signal=SDMMC2_D7
PD0.GPIO_Label=GYRO_CS
PD0.Signal=GPIO_Output
PD1.Signal=GPIO_Output
PD12.Signal=I2C4_SCL
PD13.Signal=I2C4_SDA
PD2.GPIO_Label=ACCEL_INT
PD2.Signal=GPXTI2
PD3.GPIO_Label=GYRO_INT
PD3.Signal=GPXTI3
PD5.GPIO_Label=ACCEL_CS
PD5.Signal=GPIO_Output
PD7.Signal=SDMMC2_CMD
PE11.GPIO_Label=ADXL_INT1
PE11.Signal=GPXTI11
PE12.GPIO_Label=LORA_RST
PE12.Signal=GPIO_Output
PE13.GPIO_Label=GNSS_SAFEBOOT
PE13.Signal=GPIO_Output
PE15.GPIO_Label=ANT_SW
PE15.Signal=GPIO_Output
PE3.GPIO_Label=PWM_A
PE3.Signal=S_TIM3_CH1
PE4.GPIO_Label=PWM_B
PE4.Signal=S_TIM3_CH2
PE5.GPIO_Label=PWM_C
PE5.Signal=S_TIM3_CH3
PE6.GPIO_Label=PWM_D
PE6.Signal=S_TIM3_CH4
PE9.GPIO_Label=Buzzer
PE9.Signal=S_TIM1_CH1
PH3-BOOT0.GPIO_Label=BOOT0
PH3-BOOT0.Signal=GPIO_Input
