TataThanapat/IREC2025_FlightCom/(commit log)

2025-03-21 update
    21/3/2025
    [GNSS.kicad_sch, IREC2025_FlightComputer.kicad_pcb, IREC2025_FlightComputer.kicad_sch, Miscs.kicad_sch, Sensors.kicad_sch, untitled.kicad_sch]
2025-03-22 Updated 22/3/2025
    [IREC2025_FlightComputer.kicad_pcb, IREC2025_FlightComputer.kicad_sch, Sensors.kicad_sch]
2025-03-23 Updated schematic + initiate layout
    [GNSS.kicad_sch, IREC2025_FlightComputer.kicad_pcb, IREC2025_FlightComputer.kicad_sch]
2025-03-24 update idk
    25/3/2025
    starting to take shape (i guess)
    [IREC2025_FlightComputer.kicad_pcb, IREC2025_FlightComputer.kicad_sch, Sensors.kicad_sch]
2025-04-12 checkpoint
    before the great layout change
    [GNSS.kicad_sch, IREC2025_FlightComputer.kicad_pcb, IREC2025_FlightComputer.kicad_sch, Sensors.kicad_sch, untitled.kicad_sch]
2025-04-14 Layout change
    Layout changes (Particularly GNSS and LoRa)
    [IREC2025_FlightComputer.kicad_pcb, IREC2025_FlightComputer.kicad_sch]
2025-04-15 Added via stitching
    [IREC2025_FlightComputer.kicad_pcb]
2025-04-15 small fixes
    [IREC2025_FlightComputer.kicad_pcb, IREC2025_FlightComputer.kicad_sch, Miscs.kicad_sch]
2025-04-17 Minor changes
    [IREC2025_FlightComputer.kicad_pcb]
2025-04-18 Added silkscreen + Layout Minorchange
    [IREC2025_FlightComputer.kicad_pcb, IREC2025_FlightComputer.kicad_sch, Miscs.kicad_sch]
2025-04-19 Schematics minor fixes
    [IREC2025_FlightComputer.kicad_pcb, IREC2025_FlightComputer.kicad_sch]
2025-04-20 USB Differentials matched to 90R
    [IREC2025_FlightComputer.kicad_pcb, IREC2025_FlightComputer.kicad_sch]
2025-04-20 forgor mmc int :( added
    [IREC2025_FlightComputer.kicad_pcb, IREC2025_FlightComputer.kicad_sch]
2025-04-25 2 designs
    [GNSS.kicad_sch, Miscs.kicad_sch, Sensors.kicad_sch, untitled.kicad_sch]
2025-04-30 changed most resistors to 0603
    [GNSS.kicad_sch, IREC2025_FlightComputer.kicad_sch, Miscs.kicad_sch, Sensors.kicad_sch, untitled.kicad_sch]
2025-05-02 Chore: Remove useless folders
    [IREC2025_FlightComputer.kicad_pcb, IREC2025_FlightComputer.kicad_sch, Miscs.kicad_sch, Sensors.kicad_sch, abcd.kicad_sch, connectors.kicad_sch, mirage.kicad_pcb, mirage.kicad_sch]
2025-05-02 Chore: push new design
    [GNSS.kicad_sch, IREC2025_FlightComputer.kicad_pcb, IREC2025_FlightComputer.kicad_sch, Miscs.kicad_sch, Sensors.kicad_sch, untitled.kicad_sch]
2025-05-03 update layout
    [IREC2025_FlightComputer.kicad_pcb]
2025-05-03 tung tung tung
    [IREC2025_FlightComputer.kicad_pcb, IREC2025_FlightComputer.kicad_sch]
2025-05-03 Add current limit to servo
    [IREC2025_FlightComputer.kicad_pcb, IREC2025_FlightComputer.kicad_sch]
2025-05-03 Special version
    [GNSS.kicad_sch, IREC2025_FlightComputer.kicad_pcb, IREC2025_FlightComputer.kicad_sch, Miscs.kicad_sch, Sensors.kicad_sch, untitled.kicad_sch]
2025-05-04 Chore: Add Digikey Part to symbols
    [GNSS.kicad_sch, IREC2025_FlightComputer.kicad_sch, Miscs.kicad_sch, Sensors.kicad_sch]
2025-05-04 v2 manufactured ver.
    [IREC2025_FlightComputer.kicad_pcb, IREC2025_FlightComputer.kicad_sch]
2025-05-04 Final manu v2
    [IREC2025_FlightComputer.kicad_pcb, IREC2025_FlightComputer.kicad_sch]
2025-05-16 Complete Redesign
    [IREC2025_FlightComputer.kicad_pcb, IREC2025_FlightComputer.kicad_sch, Miscs.kicad_sch, Sensors.kicad_sch, ServoConverter.kicad_pcb, ServoConverter.kicad_sch, untitled.kicad_sch]
2025-05-17 updated SD
    [IREC2025_FlightComputer.kicad_pcb]
2025-05-18 Feat: Minor improvement
    [GNSS.kicad_sch, IREC2025_FlightComputer.kicad_pcb, IREC2025_FlightComputer.kicad_sch, Miscs.kicad_sch]
2025-05-18 Feat: Replace old LDO with better LDO
    [IREC2025_FlightComputer.kicad_sch]
2025-05-18 Feat: Finish superior LDO route
    [IREC2025_FlightComputer.kicad_pcb, IREC2025_FlightComputer.kicad_sch]
2025-05-18 Feat: add silkscreen
    [IREC2025_FlightComputer.kicad_pcb]
2025-05-19 Added silkscreen + Changed gps vbackup
    [GNSS.kicad_sch, IREC2025_FlightComputer.kicad_pcb, IREC2025_FlightComputer.kicad_sch, Miscs.kicad_sch, Sensors.kicad_sch, untitled.kicad_sch]
2025-05-20 Ordered version
    [IREC2025_FlightComputer.kicad_pcb, IREC2025_FlightComputer.kicad_sch]
2025-05-31 fixes
    Fixed mmc, power
    Added external 5V Supply
    Added external reset button
    [IREC2025_FlightComputer.kicad_pcb, IREC2025_FlightComputer.kicad_sch, Miscs.kicad_sch, Sensors.kicad_sch]
